ryedwards/budgetcan-g0-hw/README.md

# BUDGETCANFD_G0-Hardware
 BUDGETCANFD_G0-Hardware files

# HARDWARE IMAGE
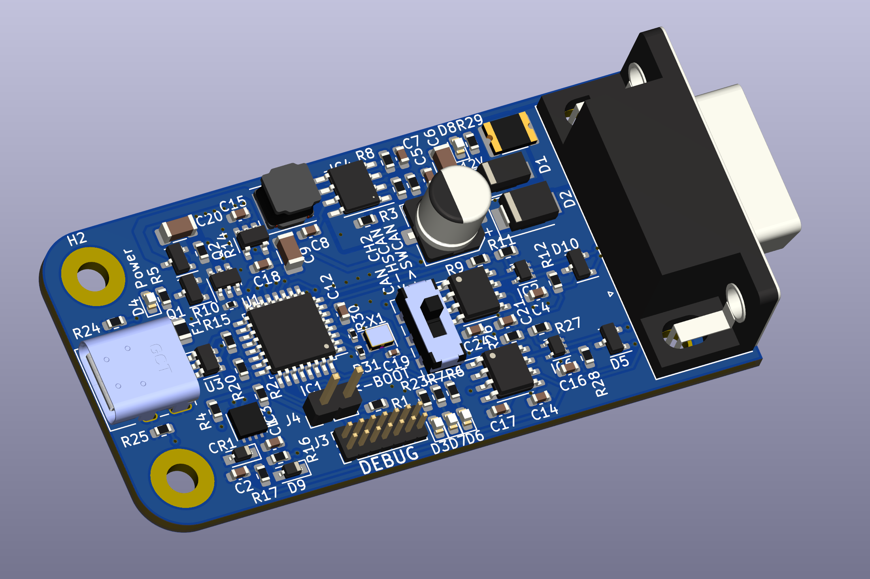
[picture p1: BudgetCANFD_G0.png]
BUDGETCANFD_G0-Hardware
