ryedwards/budgetcan-g0-hw/3dmodels/MF-TJA1021TK.STEP

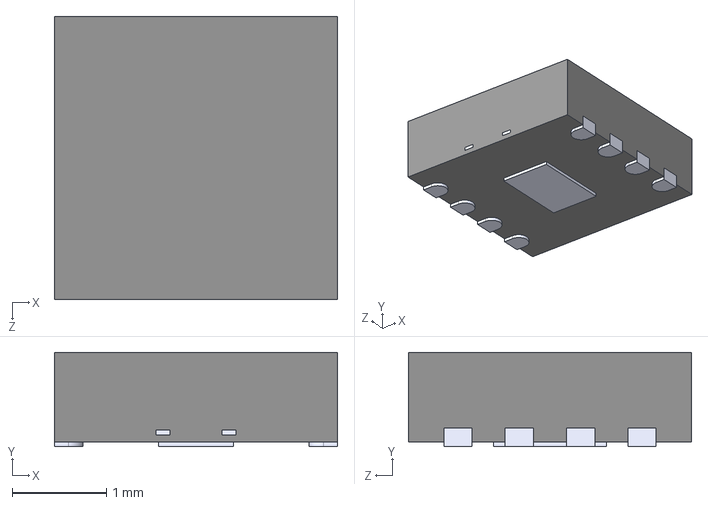
[picture p2: CAD file, 2022-11-19]
3dmodels/MF-TJA1021TK.STEP
3.00 x 1.00 x 3.00 mm
