ryedwards/budgetcan-g0-hw/3dmodels/LQH5BPN3R3N38L.STEP

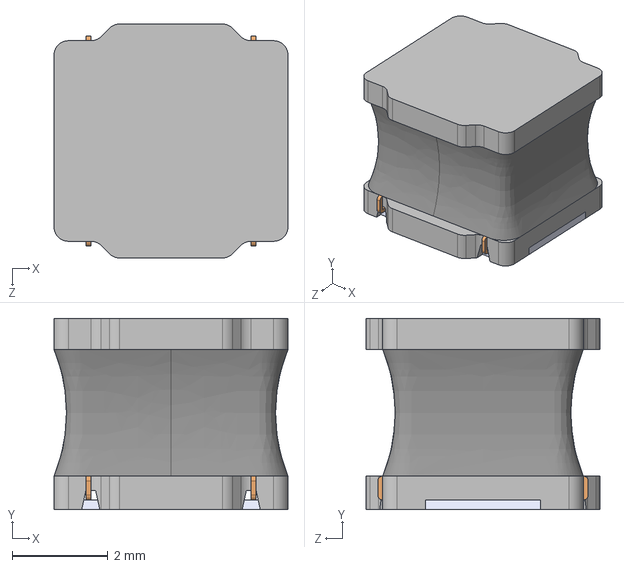
[picture p3: CAD file, 2022-11-19]
3dmodels/LQH5BPN3R3N38L.STEP
4.90 x 4.00 x 4.90 mm
