ryedwards/budgetcan-g0-hw/3dmodels/ECS-2520MVLC-080-BN-TR.STEP

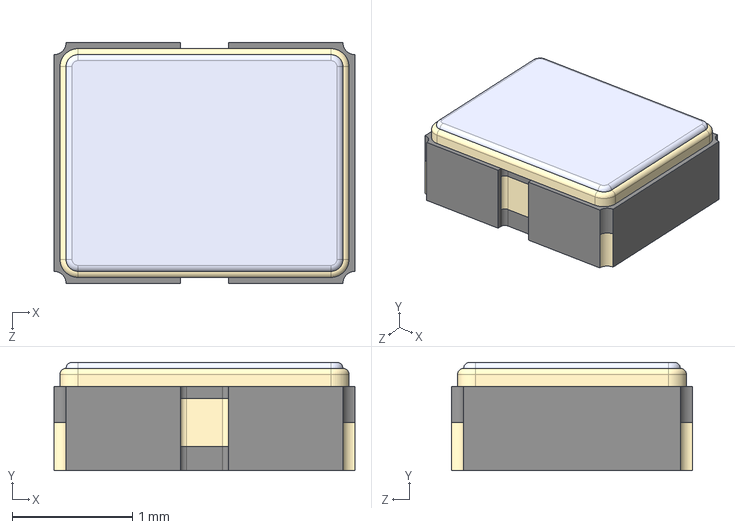
[picture p4: CAD file, 2022-11-19]
3dmodels/ECS-2520MVLC-080-BN-TR.STEP
2.50 x 0.9 x 2.00 mm
