ryedwards/budgetcan-g0-hw/3dmodels/MF-MSMF050.STEP

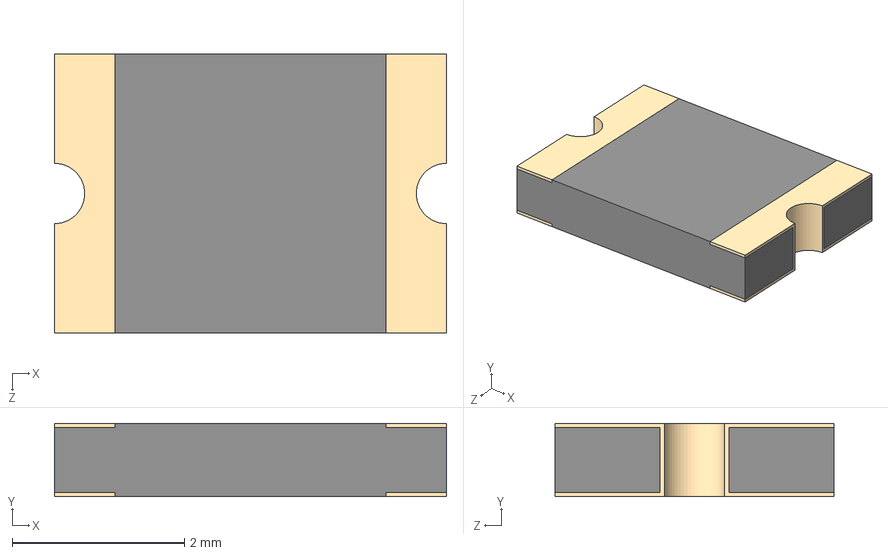
[picture p5: CAD file, 2022-11-19]
3dmodels/MF-MSMF050.STEP
4.55 x 0.85 x 3.24 mm
