ryedwards/budgetcan-g0-hw/3dmodels/JS202011JCQN.STEP

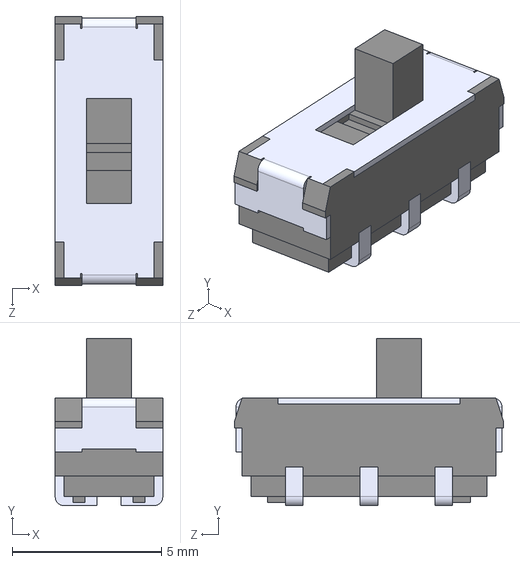
[picture p6: CAD file, 2022-11-19]
3dmodels/JS202011JCQN.STEP
3.60 x 5.60 x 9.00 mm
