ryedwards/budgetcan-g0-hw/BudgetCANFD_G0.pdf

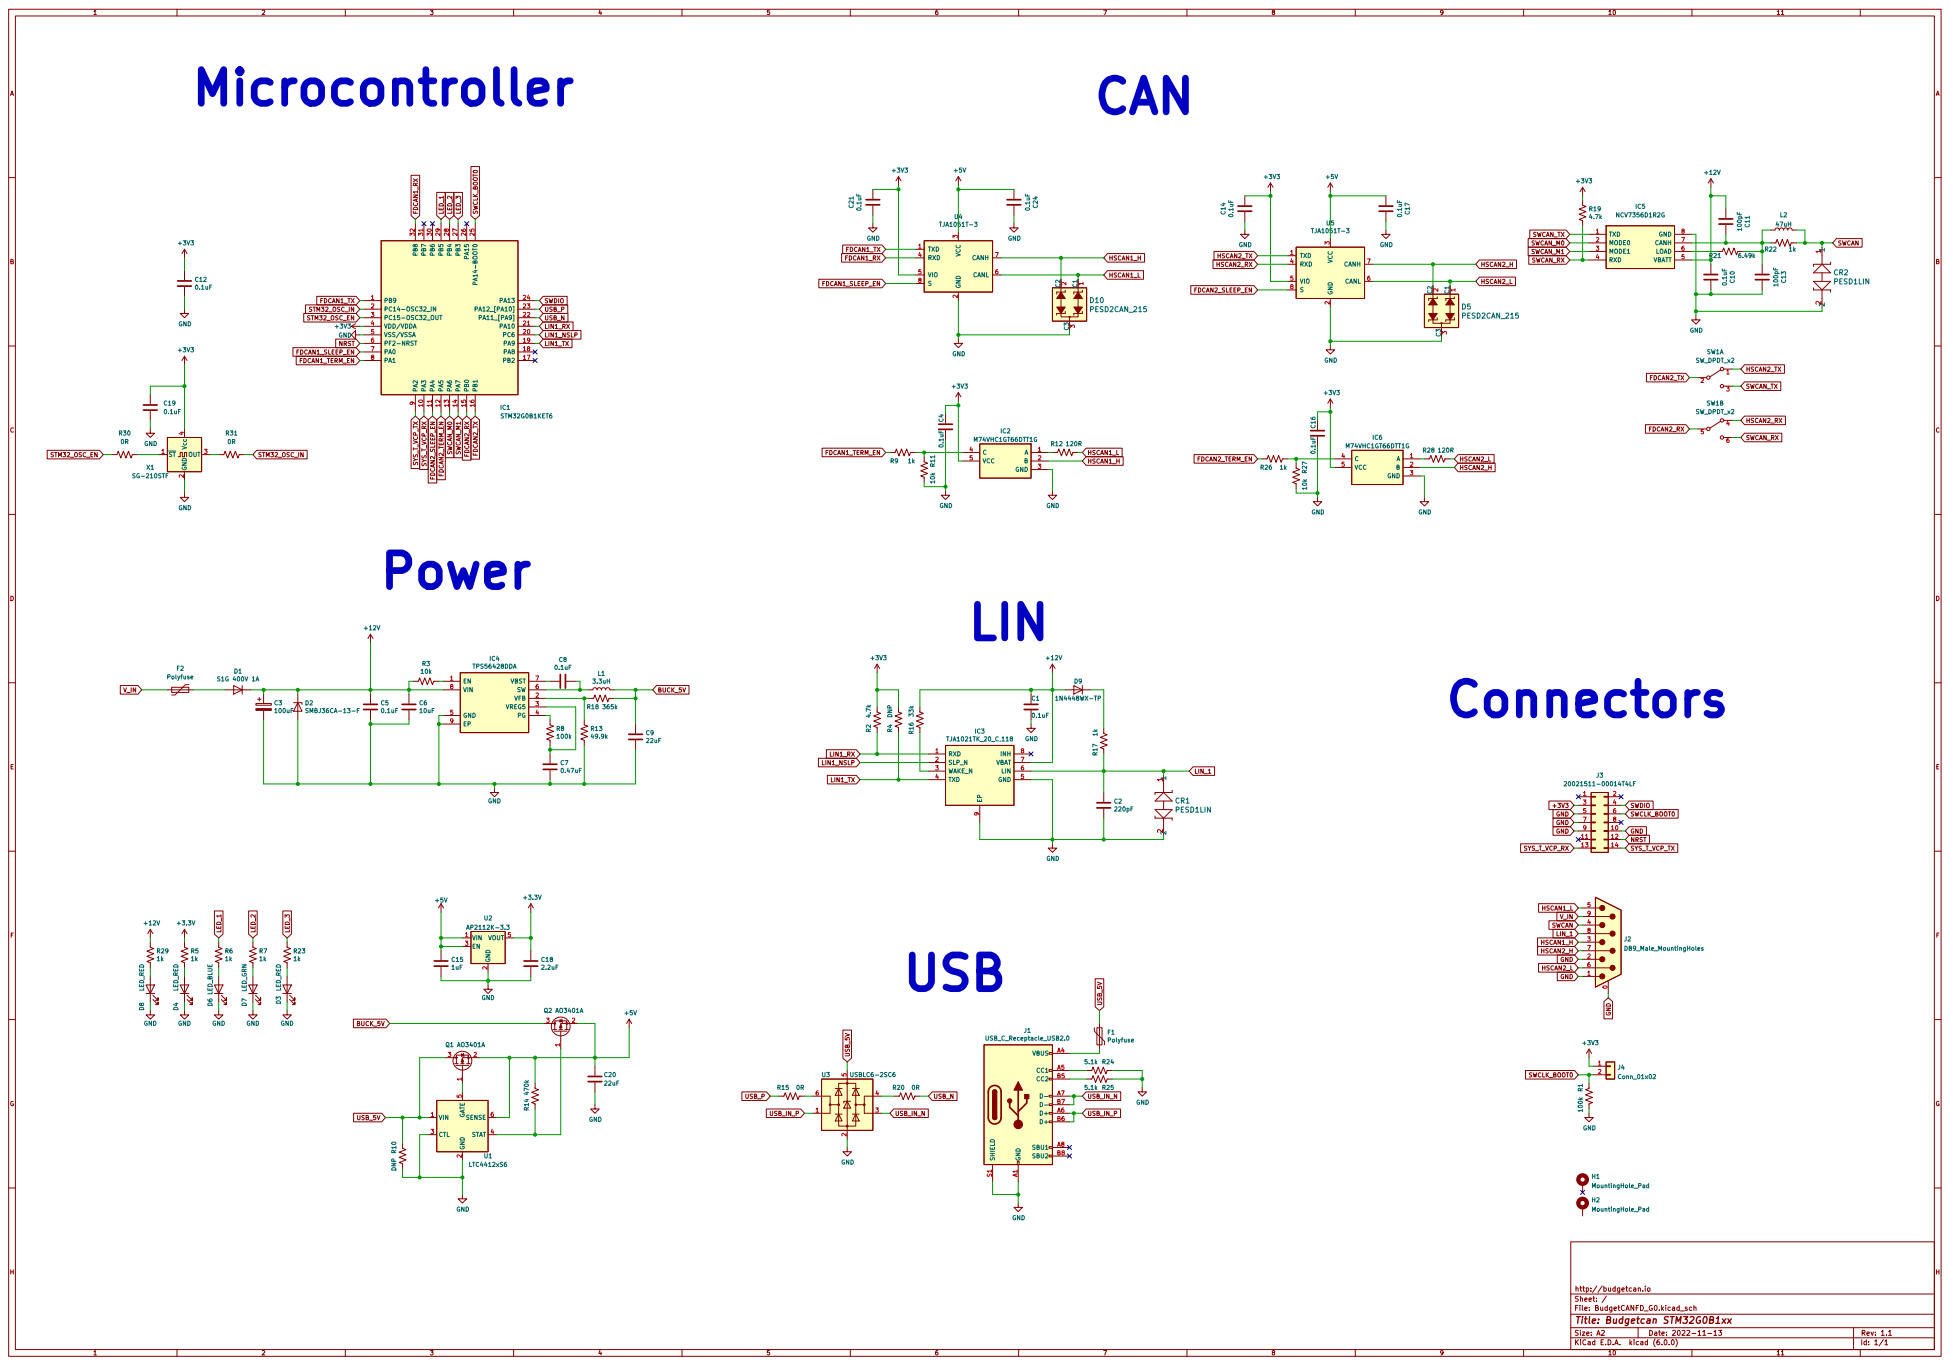
[picture p7: page 1]

3 RXD 4 VIO 5 CANL 6 CANH 7 S

File: BudgetCANFD_G0.kicad_sch Sheet: / http://budgetcan.io
