ryedwards/budgetcan-g0-hw/BudgetCANFD_G0.kicad_pcb

## KiCad design BudgetCANFD_G0.kicad_pcb (2023-02-22)

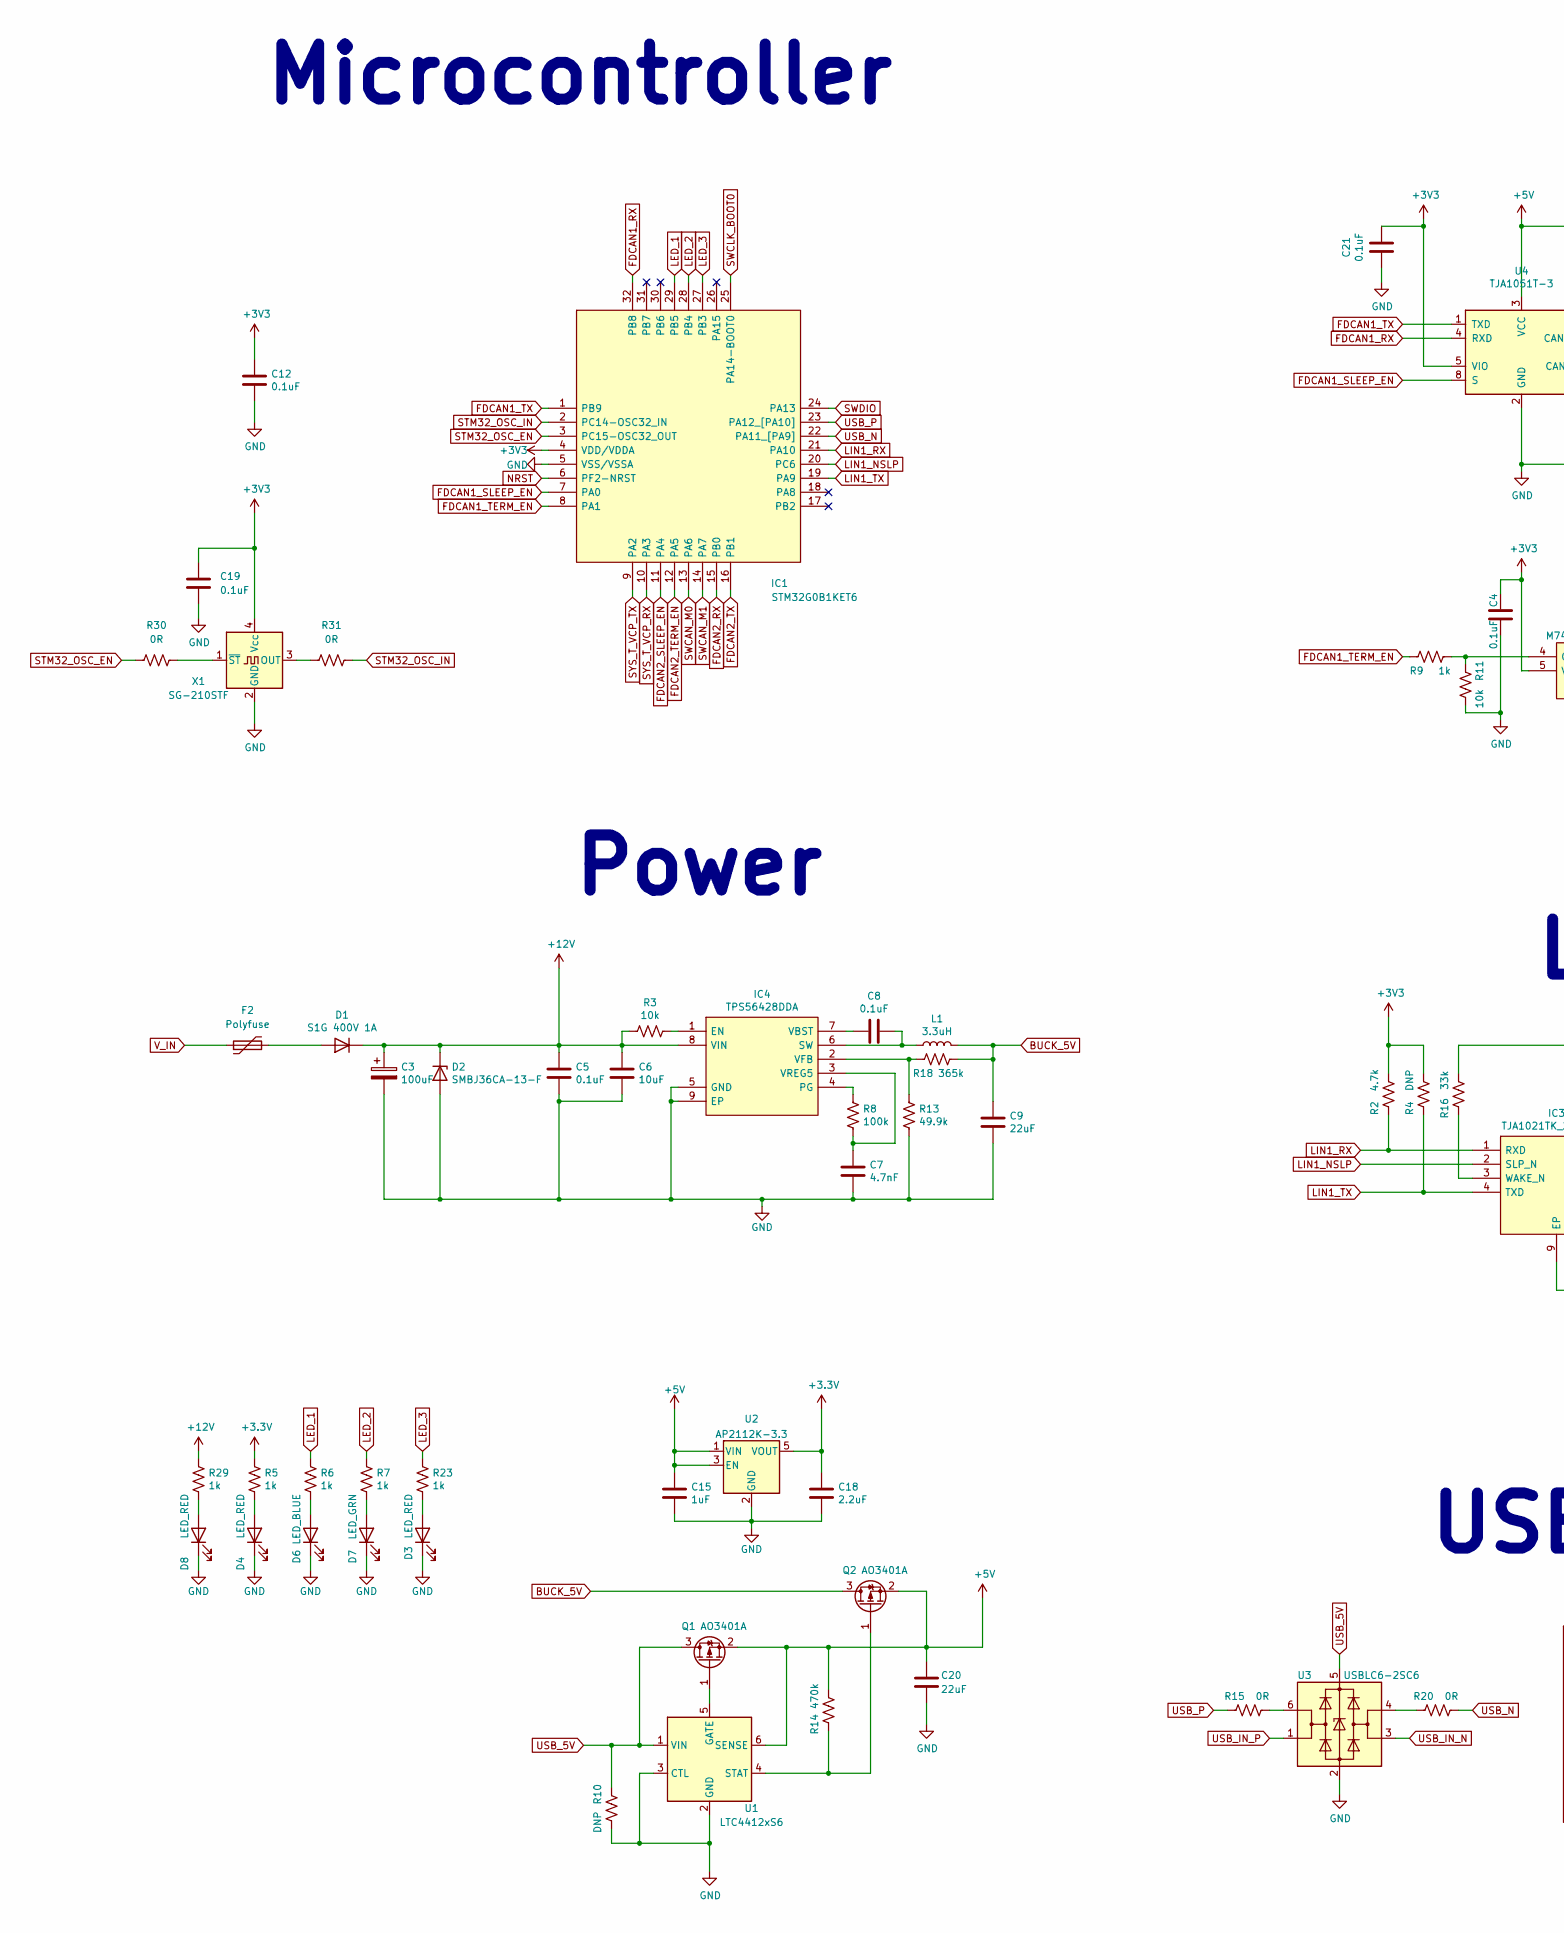
[picture p8: schematic BudgetCANFD_G0.kicad_sch, Budgetcan STM32G0B1xx, part in row 1, column 1]

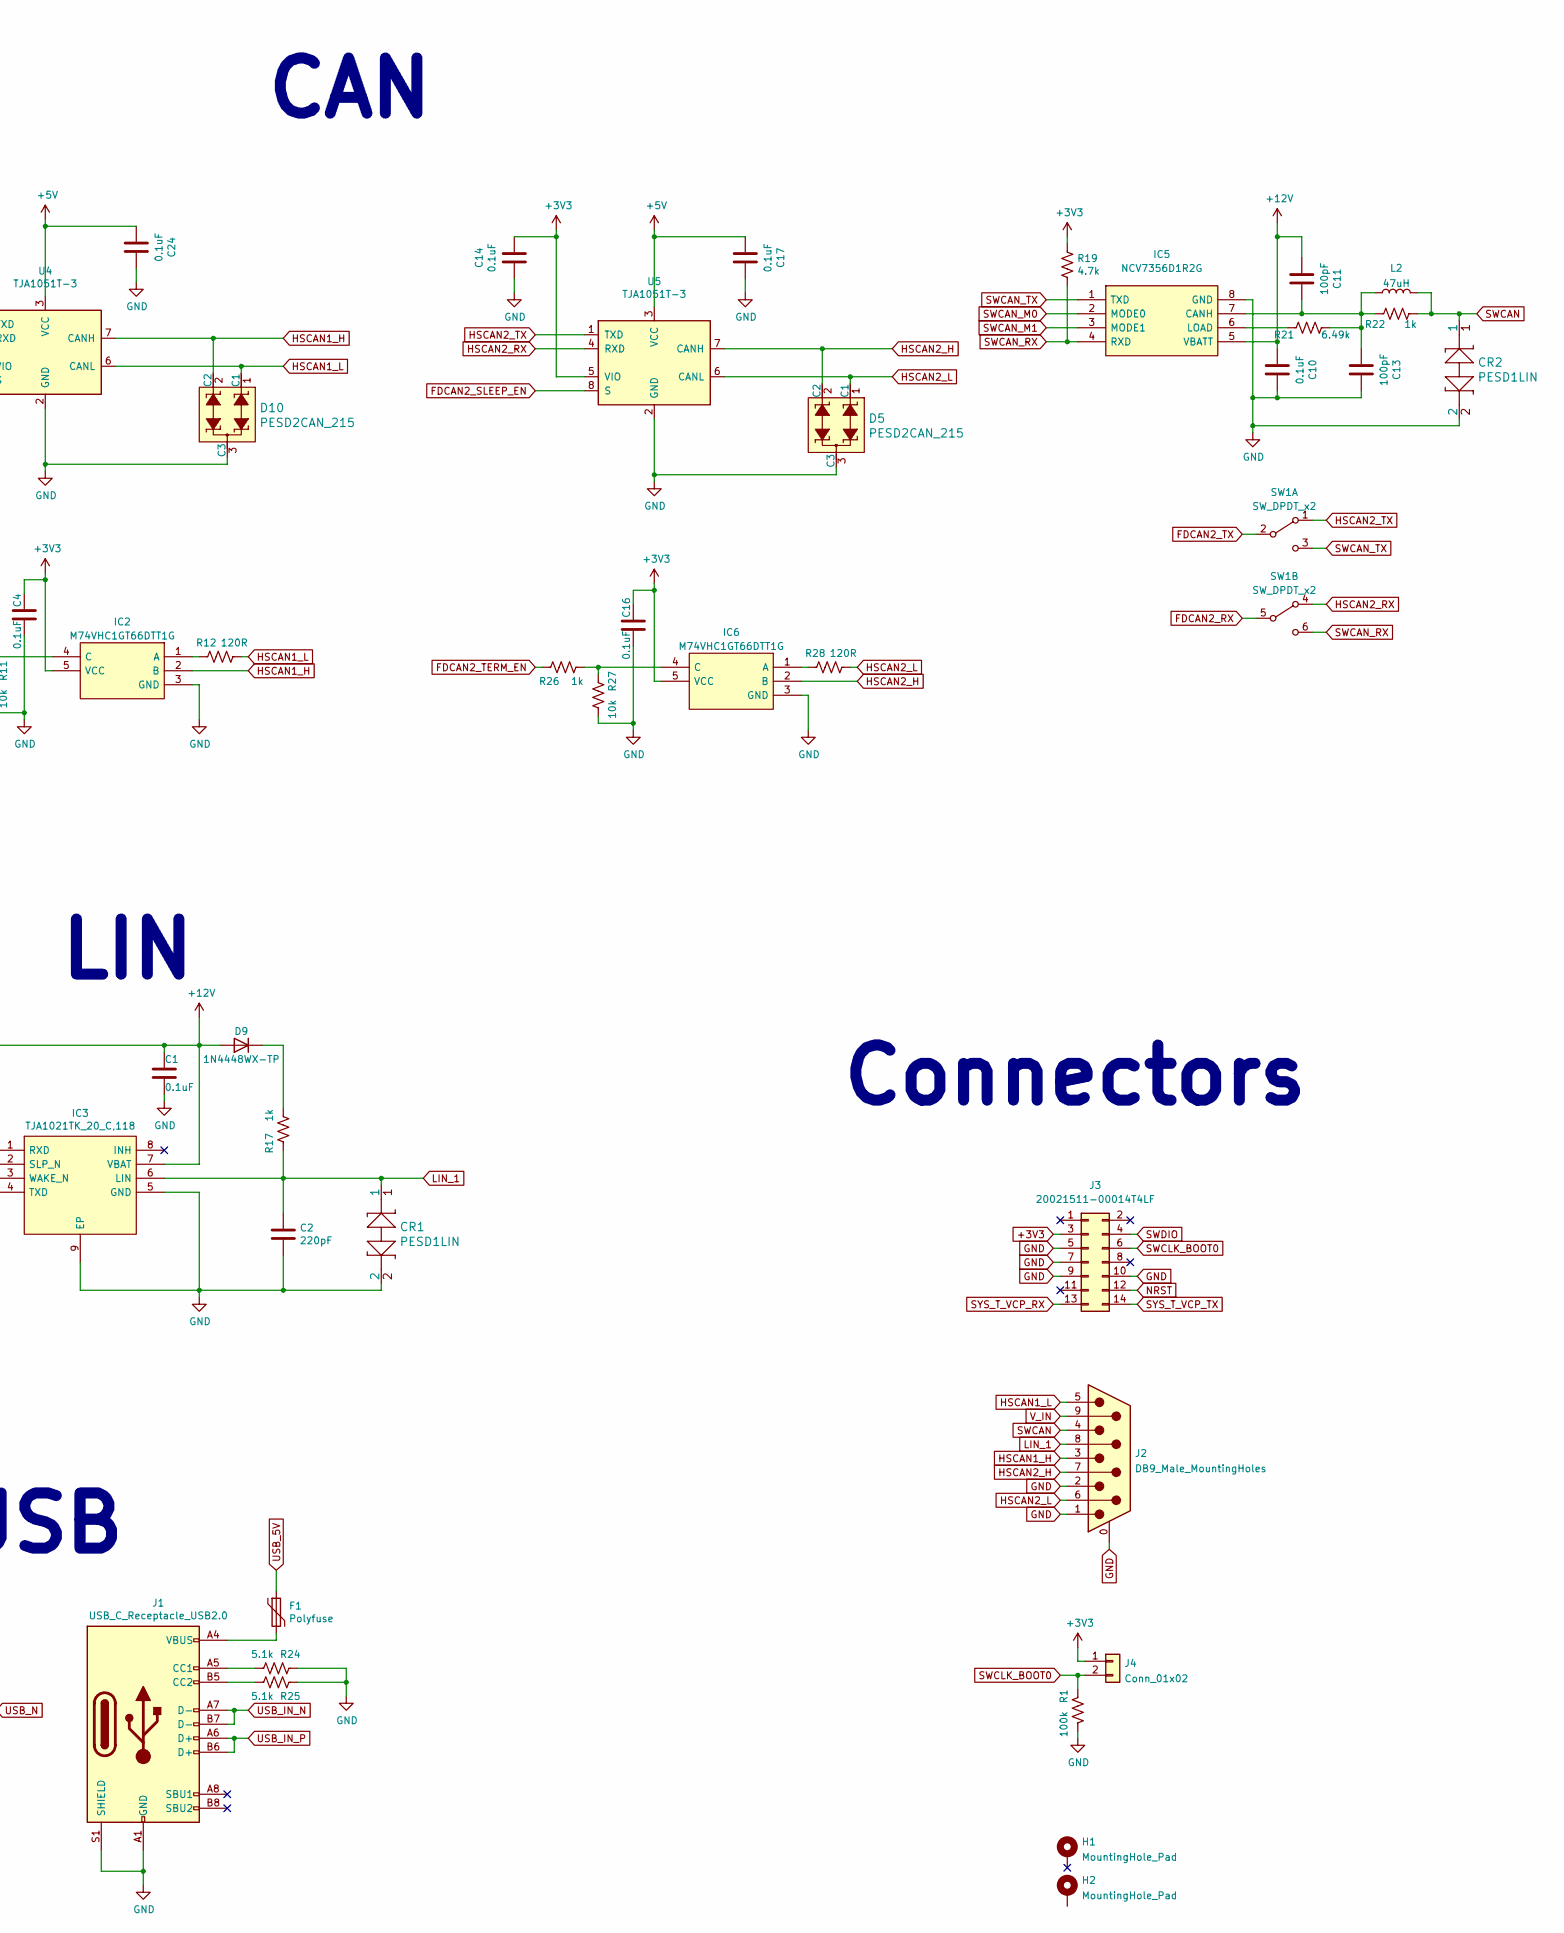
[picture p9: schematic BudgetCANFD_G0.kicad_sch, Budgetcan STM32G0B1xx, part in row 1, column 2]

Parts:
C1, C4, C5, C8, C10, C12, C14, C16, C17, C21, C24: 0.1uF; C_0603_1608Metric; Manufacturer_Part_Number CC0603KRX7R8BB104; LCSC Part # C14663
C2: 220pF; C_0603_1608Metric; Manufacturer_Part_Number CC0603JRNPO9BN221; LCSC Part # C1603
C3: 100uF; CP_Elec_6.3x7.7; Manufacturer_Part_Number EMZA250ADA101MF80G; LCSC Part # C127971
C6: 10uF; C_1206_3216Metric; Manufacturer_Part_Number CL31B106KQHNFNE; LCSC Part # C13585
C7: 4.7nF; C_0603_1608Metric; Manufacturer_Part_Number CGA3E2X7R2A472K080AA; LCSC Part # C53987
C9, C20: 22uF; C_1206_3216Metric; Manufacturer_Part_Number EMK316ABJ226ML-T; LCSC Part # C90146
C11, C13: 100pF; C_0805_2012Metric; Manufacturer_Part_Number CC0603KRX7R8BB104; LCSC Part # C14663
C15: 1uF; C_0603_1608Metric; Manufacturer_Part_Number CC0603KRX7R8BB104; LCSC Part # C14663
C18: 2.2uF; C_0603_1608Metric; Manufacturer_Part_Number CC0603KRX7R8BB104; LCSC Part # C14663
C19: 0.1uF; C_0402_1005Metric; Digi-Key_PN 1276-1002-1-ND
CR1, CR2: PESD1LIN; D_SOD-323_HandSoldering; Manufacturer_Part_Number PESD1LIN,135; LCSC Part # C58901
D1: S1G 400V 1A; D_SMA; Manufacturer_Part_Number S1G; LCSC Part # C412437
D2: SMBJ36CA-13-F; D_SMB; Manufacturer_Part_Number SMBJ36CA-13-F; LCSC Part # C78421
D3, D4, D8: LED_RED; LED_0603_1608Metric; Manufacturer_Part_Number LS Q976-NR-1; LCSC Part # C2286
D5, D10: PESD2CAN_215; SOT-23; MPN PESD2CAN,215; Digi-Key_PN 1727-3891-1-ND
D6: LED_BLUE; LED_0603_1608Metric; Manufacturer_Part_Number LB Q39E-N1OO-35-1; LCSC Part # C72041
D7: LED_GRN; LED_0603_1608Metric; Manufacturer_Part_Number LG Q396-PS-35; LCSC Part # C72043
D9: ‎1N4448WX-TP‎; D_SOD-323_HandSoldering; Manufacturer_Part_Number ‎1N4448WX-TP‎; Digi-Key_PN 1N4448WXTPMSCT-ND
F1: Polyfuse; Fuse_0805_2012Metric; Manufacturer_Part_Number 0ZCK0035FF2G; LCSC Part # C369150
F2: Polyfuse; Fuse_1812_4532Metric; Manufacturer_Part_Number 0ZCG0200AF2B; Digi-Key_PN 507-2074-1-ND
H1, H2: MountingHole_Pad; MountingHole_3.2mm_M3_Pad_TopBottom
IC1: STM32G0B1KET6; LQFP-32_7x7mm_P0.8mm; Mouser Part Number 511-STM32G0B1KET6
IC2, IC6: M74VHC1GT66DTT1G; SOT-353_SC-70-5; Mouser Part Number 595-LVC1G66QDCKRQ1
IC3: TJA1021TK_20_C,118; HVSON-8-1EP_3x3mm_P0.65mm_EP1.6x2.4mm; Mouser Part Number 771-TJA1021TK20C1
IC4: TPS56428DDA; HSOP-8-1EP_3.9x4.9mm_P1.27mm_EP2.41x3.1mm_ThermalVias; Mouser Part Number 595-TPS56428DDA
IC5: NCV7356D1R2G; SOIC-8_3.9x4.9mm_P1.27mm; Manufacturer_Part_Number TH8056KDC-A8; Digi-Key_PN NCV7356D1R2GOSCT-ND
J1: USB_C_Receptacle_USB2.0; USB_C_Receptacle_GCT_USB4085; Manufacturer_Part_Number USB4085-GF-A; Digi-Key_PN 2073-USB4085-GF-ACT-ND
J2: DB9_Male_MountingHoles; DSUB-9_Male_Horizontal_P2.77x2.84mm_EdgePinOffset4.94mm_Hou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; Digi-Key_PN AE10968-ND
J3: 20021511-00014T4LF; PinHeader_2x07_P1.27mm_Vertical; Mouser Part Number 200-FTSH10701LDK
J4: Conn_01x02; PinHeader_1x02_P2.54mm_Vertical
L1: 3.3uH; L_Taiyo-Yuden_NR-50xx; LCSC Part # C167908
L2: 47uH; L_0805_2012Metric; Digi-Key_PN 490-4031-1-ND
Q1, Q2: AO3401A; SOT-23; LCSC Part # C15127
R1, R8: 100k; R_0603_1608Metric; Manufacturer_Part_Number RC0603FR-07100KL; LCSC Part # C25803
R2, R19: 4.7k; R_0603_1608Metric; Manufacturer_Part_Number RC0603JR-074K7L; LCSC Part # C23162
R3, R11, R27: 10k; R_0603_1608Metric; Manufacturer_Part_Number RC0603FR-0710KL; LCSC Part # C25804
R4: DNP; R_0603_1608Metric
R5, R6, R7, R9, R17, R23, R26, R29: 1k; R_0603_1608Metric; Manufacturer_Part_Number RC0603FR-071KL; LCSC Part # C21190
R10: DNP; R_0402_1005Metric
R12, R28: 120R; R_0603_1608Metric; Manufacturer_Part_Number RC0603FR-07120RL; LCSC Part # C22787
R13: 49.9k; R_0603_1608Metric; Manufacturer_Part_Number AF0603FR-0749K9L; LCSC Part # C23184
R14: 470k; R_0603_1608Metric; Manufacturer_Part_Number RC0603FR-07470KL; LCSC Part # C23178
R15, R20: 0R; R_0603_1608Metric; Manufacturer_Part_Number RC0603JR-070RL; LCSC Part # C21189
R16: 33k; R_0603_1608Metric; Manufacturer_Part_Number RC0603FR-0733K2L; LCSC Part # C4216
R18: 365k; R_0603_1608Metric; Manufacturer_Part_Number 13-AC0603FR-07365KLCT-ND; LCSC Part # C23031
R21: 6.49k; R_1206_3216Metric; Digi-Key_PN P6.49KFCT-ND
R22: 1k; R_1206_3216Metric; Manufacturer_Part_Number RC0603FR-071KL; LCSC Part # C21190
R24, R25: 5.1k; R_0603_1608Metric; Manufacturer_Part_Number RC0603JR-075K1L; LCSC Part # C23186
R30, R31: 0R; R_0402_1005Metric; Digi-Key_PN CR0402AJ/-000GASCT-ND
SW1: SW_DPDT_x2; SW_DPDT_CK_JS202011JCQN; Manufacturer_Part_Number JS202011JCQN; Digi-Key_PN CKN10723CT-ND
U1: LTC4412xS6; TSOT-23-6; Manufacturer_Part_Number LTC4412xS6; LCSC Part # C521306
U2: AP2112K-3.3; SOT-23-5; Manufacturer_Part_Number AP2112K-3.3; LCSC Part # C51118
U3: USBLC6-2SC6; SOT-23-6; Manufacturer_Part_Number USBLC6-2SC6; LCSC Part # C2687116
U4, U5: TJA1051T-3; SOIC-8_3.9x4.9mm_P1.27mm; LCSC Part # C38695
X1: SG-210STF; Oscillator_SMD_SeikoEpson_SG210-4Pin_2.5x2.0mm; Digi-Key_PN 50-ECS-2520MVLC-080-BN-CT-ND

Connections:
+5V: C15.1, C17.2, C20.1, C24.2, Q1.2 (S), Q2.2 (S), R14.2, U1.6 (SENSE), U2.1 (VIN), U2.3 (EN), U4.3 (VCC), U5.3 (VCC)
+12V: C1.1, C3.1, C5.1, C6.1, C10.2, C11.2, D1.1 (K), D2.1 (K), D9.2 (A), IC3.7 (VBAT), IC4.8 (VIN), IC5.5 (VBATT), R3.2, R16.2, R29.2
BUCK_5V: C9.1, L1.2, Q2.3 (D), R18.1
FDCAN1_RX: IC1.32 (PB8), U4.4 (RXD)
FDCAN1_SLEEP_EN: IC1.7 (PA0), U4.8 (S)
FDCAN1_TERM_EN: IC1.8 (PA1), R9.1
FDCAN1_TX: IC1.1 (PB9), U4.1 (TXD)
FDCAN2_RX: IC1.15 (PB0), SW1.5 (B)
FDCAN2_SLEEP_EN: IC1.11 (PA4), U5.8 (S)
FDCAN2_TERM_EN: IC1.12 (PA5), R26.1
FDCAN2_TX: IC1.16 (PB1), SW1.2 (B)
GND: C1.2, C2.2, C3.2, C4.2, C5.2, C6.2, C7.2, C9.2, C10.1, C12.2, C13.1, C14.2, C15.2, C16.2, C17.1, C18.2, C19.2, C20.2, C21.2, C24.1, CR1.2, CR2.2, D2.2 (A), D3.1 (K), D4.1 (K), D5.3 (C3), D6.1 (K), D7.1 (K), D8.1 (K), D10.3 (C3), IC1.5 (VSS/VSSA), IC2.3 (GND), IC3.5 (GND), IC3.9 (EP), IC4.5 (GND), IC4.9 (EP), IC5.8 (GND), IC6.3 (GND), J1.A1 (GND), J1.A12 (GND), J1.B1 (GND), J1.B12 (GND), J1.S1 (SHIELD), J2.0 (PAD), J2.1, J2.2, J3.5, J3.7, J3.9, J3.10, R1.2, R10.2, R11.2, R13.2, R24.1, R25.1, R27.2, U1.2 (GND), U1.3 (CTL), U2.2 (GND), U3.2 (GND), U4.2 (GND), U5.2 (GND), X1.2 (GND)
HSCAN1_H: D10.2 (C2), IC2.2 (B), J2.3, U4.7 (CANH)
HSCAN1_L: D10.1 (C1), J2.5, R12.2, U4.6 (CANL)
HSCAN2_H: D5.2 (C2), IC6.2 (B), J2.7, U5.7 (CANH)
HSCAN2_L: D5.1 (C1), J2.6, R28.2, U5.6 (CANL)
HSCAN2_RX: SW1.4 (A), U5.4 (RXD)
HSCAN2_TX: SW1.1 (A), U5.1 (TXD)
LED_1: IC1.29 (PB5), R6.2
LED_2: IC1.28 (PB4), R7.2
LED_3: IC1.27 (PB3), R23.2
LIN1_NSLP: IC1.20 (PC6), IC3.2 (SLP_N)
LIN1_RX: IC1.21 (PA10), IC3.1 (RXD), R2.1
LIN1_TX: IC1.19 (PA9), IC3.4 (TXD), R4.1
LIN_1: C2.1, CR1.1, IC3.6 (LIN), J2.8, R17.1
NRST: IC1.6 (PF2-NRST), J3.12
unnamed: C7.1, IC4.3 (VREG5), R8.2
unnamed: C8.1, IC4.6 (SW), L1.1
unnamed: C8.2, IC4.7 (VBST)
unnamed: C11.1, C13.2, IC5.7 (CANH), L2.1, R21.1, R22.2
unnamed: D1.2 (A), F2.2
unnamed: D3.2 (A), R23.1
unnamed: D4.2 (A), R5.1
unnamed: D6.2 (A), R6.1
unnamed: D7.2 (A), R7.1
unnamed: D8.2 (A), R29.1
unnamed: D9.1 (K), R17.2
unnamed: F1.2, J1.A4 (VBUS), J1.A9 (VBUS), J1.B4 (VBUS), J1.B9 (VBUS)
unnamed: IC2.1 (A), R12.1
unnamed: IC2.4 (C), R9.2, R11.1
unnamed: IC3.3 (WAKE_N), R16.1
unnamed: IC4.1 (EN), R3.1
unnamed: IC4.2 (VFB), R13.1, R18.2
unnamed: IC4.4 (PG), R8.1
unnamed: IC5.6 (LOAD), R21.2
unnamed: IC6.1 (A), R28.1
unnamed: IC6.4 (C), R26.2, R27.1
unnamed: J1.A5 (CC1), R24.2
unnamed: J1.B5 (CC2), R25.2
unnamed: Q1.1 (G), U1.5 (GATE)
unnamed: Q2.1 (G), R14.1, U1.4 (STAT)
unnamed: R15.2, U3.6 (I/O1)
unnamed: R20.1, U3.4 (I/O2)
unnamed: R30.1, X1.1 (~ST)
unnamed: R31.2, X1.3 (OUT)
STM32_OSC_EN: IC1.3 (PC15-OSC32_OUT), R30.2
STM32_OSC_IN: IC1.2 (PC14-OSC32_IN), R31.1
SWCAN: CR2.1, J2.4, L2.2, R22.1
SWCAN_M0: IC1.13 (PA6), IC5.2 (MODE0)
SWCAN_M1: IC1.14 (PA7), IC5.3 (MODE1)
SWCAN_RX: IC5.4 (RXD), R19.1, SW1.6 (C)
SWCAN_TX: IC5.1 (TXD), SW1.3 (C)
SWCLK_BOOT0: IC1.25 (PA14-BOOT0), J3.6, J4.2, R1.1
SWDIO: IC1.24 (PA13), J3.4
SYS_T_VCP_RX: IC1.10 (PA3), J3.13
SYS_T_VCP_TX: IC1.9 (PA2), J3.14
USB_5V: F1.1, Q1.3 (D), R10.1, U1.1 (VIN), U3.5 (VBUS)
USB_IN_N: J1.A7 (D-), J1.B7 (D-), U3.3 (I/O2)
USB_IN_P: J1.A6 (D+), J1.B6 (D+), U3.1 (I/O1)
USB_N: IC1.22 (PA11_[PA9]), R20.2
USB_P: IC1.23 (PA12_[PA10]), R15.1
V_IN: F2.1, J2.9

Notes on the sheet:
LIN
Microcontroller
CAN
Power
USB
Connectors

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
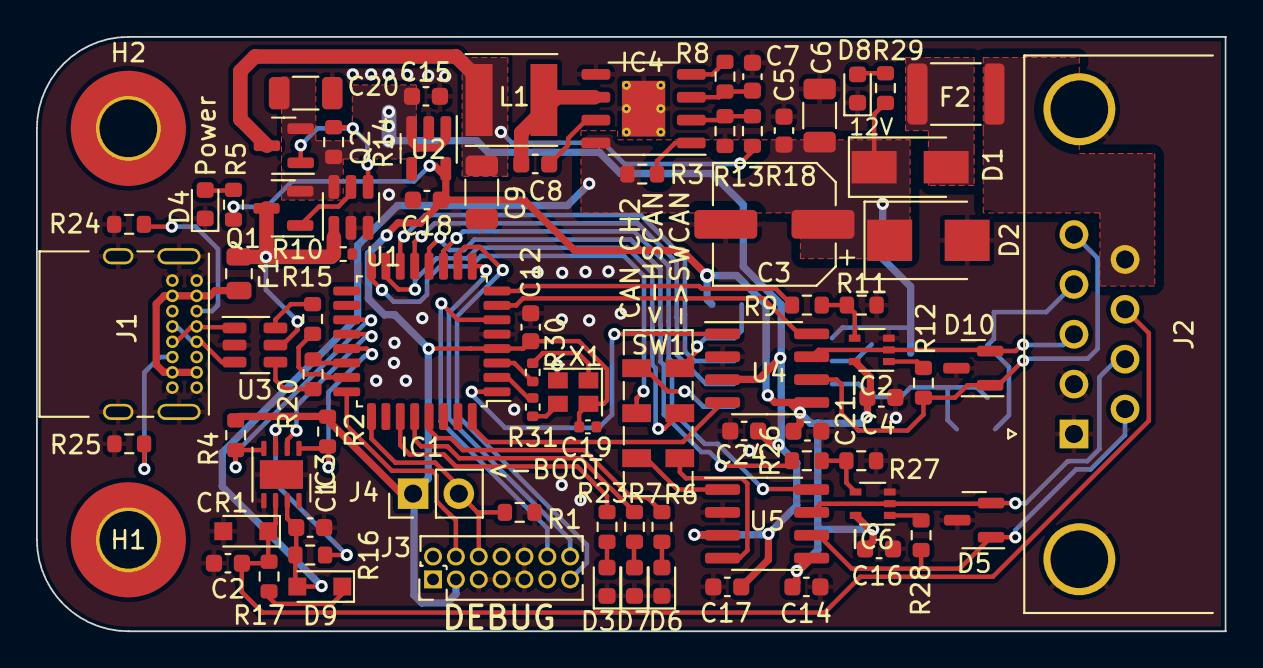
[picture p10: board BudgetCANFD_G0.kicad_pcb from above]

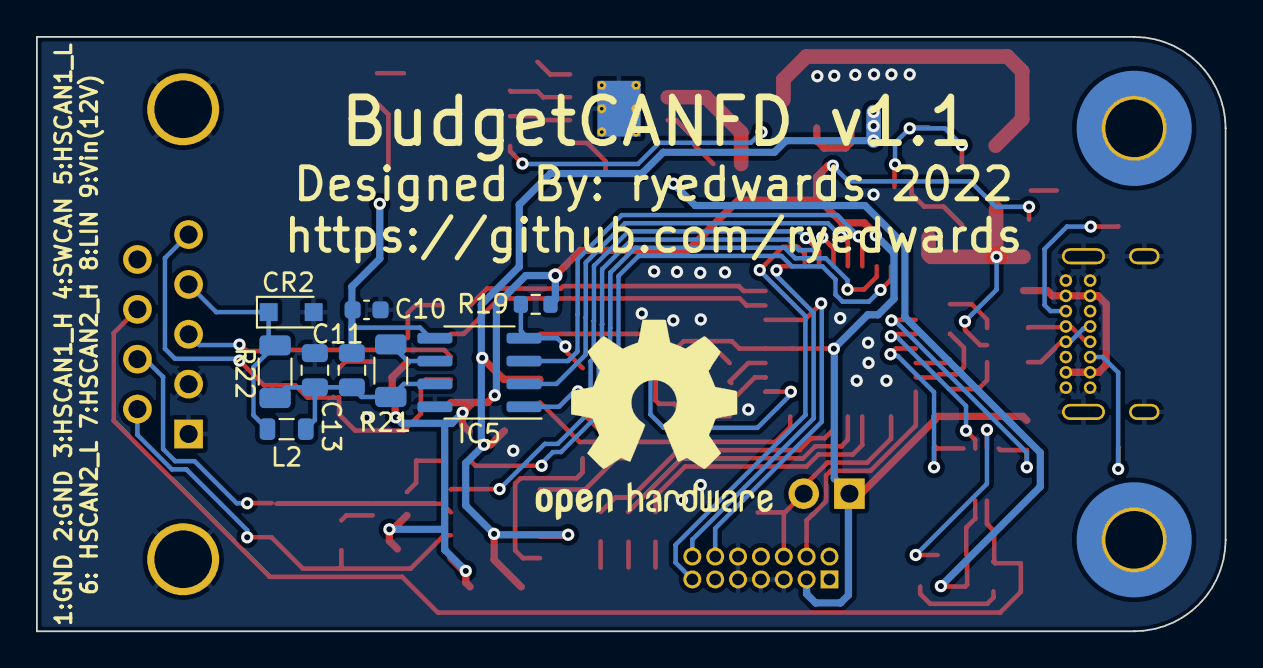
[picture p11: board BudgetCANFD_G0.kicad_pcb from below]

Board: 2 copper layers, 66.0 x 33.0 mm, 90 parts (9 on the bottom side), 73 nets.
