ryedwards/budgetcan-g0-hw/(commit log)

2022-11-19 Update to v1.1
    Add support for an external clock if needed in the future
    [BudgetCANFD_G0.kicad_pcb, BudgetCANFD_G0.kicad_sch, ECS-2520MVLC-080-BN-TR.STEP, JS202011JCQN.STEP, LQH5BPN3R3N38L.STEP, MF-MSMF050.STEP, MF-TJA1021TK.STEP]
2022-11-29 Update BOM
    Update part numbers for LCSC parts
    [BudgetCANFD_G0.kicad_pcb, BudgetCANFD_G0.kicad_sch]
2023-02-22 Add BOM and updated part numbers
    [BudgetCANFD_G0.csv, BudgetCANFD_G0.kicad_pcb, BudgetCANFD_G0.kicad_sch]
